imove0n/tomato-sorter/(commit log)

2026-04-26 Add NCNN model inference and camera streaming functionality
    - Implemented a new script `test_camera.py` for capturing video from the camera and performing inference using the NCNN model.
    - Created a new Python file `model_ncnn.py` for testing NCNN model inference.
    - Added model weights file `last.pt` for the trained NCNN model.
    - Introduced `pyproject.toml` for project dependencies and configuration.
    - Updated `PKG-INFO` and other egg-info files for packaging.
    - Added optional development dependencies for testing.
    [best.ncnn.param, model.ncnn.param, results.csv]
2026-04-27 Implement SQLite database for logging detections, sensor readings, and system events; add detector for YOLO inference; create main application entry point; develop orchestrator for sorting logic; est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
    [servo_angles.json]
2026-04-27 Enhance detection and sorting logic: update cycle timing parameters, improve camera handling, and add diagnostic API for Arduino messages; redesign dashboard for live detection display; introduce cam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
    [camera_viewer.py, detector.py, orchestrator.py, server.py, settings.yaml]
2026-04-27 Clean source control: add .gitignore, untrack binaries, save calibration
    - Add .gitignore to exclude SQLite DB, models, venv, logs, IDE files
    - Untrack data/sorter.db and all model binaries (still on disk, just not in git)
    - Update Servo 2 calibrated angles in firmware (left=122, center=90, right=55)
    - Save new servo_angles.json from calibration session
    [best.ncnn.param, model.ncnn.param, results.csv, servo_angles.json]
2026-05-03 Add reset functionality to clear detections, sensor readings, and events; update dashboard with reset button and API endpoint
    [database.py, sensors.py, server.py]
2026-05-03 Add troubleshooting guidance for servo movement issues and firmware management
2026-05-03 Add calibration tools for Servo 2 and Servo 3, including dual calibration script and continuous rotation calibration script; update servo angles configuration
    [servo_angles.json]
2026-05-03 Add servo2 configuration for open and closed angles in servo_angles.json
    [servo_angles.json]
2026-05-03 Fix servo2 closed angle in servo_angles.json from 95 to 89
    [servo_angles.json]
2026-05-05 Add Servo 4 support, including calibration sketches, configuration, and dashboard controls
    [servo_angles.json]
2026-05-05 update 5/6/2026
    [servo_angles.json]
2026-05-05 Refactor Tomato Sorter Firmware and Backend Integration
    - Removed Servo 1 (gate) functionality from firmware; it is now disabled and acknowledged as such in serial commands.
    - Updated servo angles in configuration files to reflect new default positions.
    - Enhanced IR sensor handling with debouncing and state management.
    - Implemented auto-oscillation for Servo 4 with configurable timing.
    - Modified orchestrator to handle new IR trigger simulation for testing.
    - Updated dashboard to reflect changes in gate status and sorter position.
    - Added deployment scripts for flashing firmware and setting up autostart services.
    - Improved logging and error handling in the backend service.
    [servo_angles.json]
2026-05-07 Add system control buttons for shutdown, reboot, and exit kiosk; implement corresponding API endpoints
    [server.py]
2026-05-16 Add conveyor speed control to dashboard and API; enhance conveyor functionality
2026-05-27 Add wiring documentation and PDF generation script for Tomato Sorter v2.0
2026-06-27 Add fullscreen camera overlay to dashboard with live stream functionality
2026-06-27 Add Cloudflare tunnel support and update phone access button title in dashboard
